grmono/ARDUINO/skarsta/models/hall-encoder/hall-mount.stl

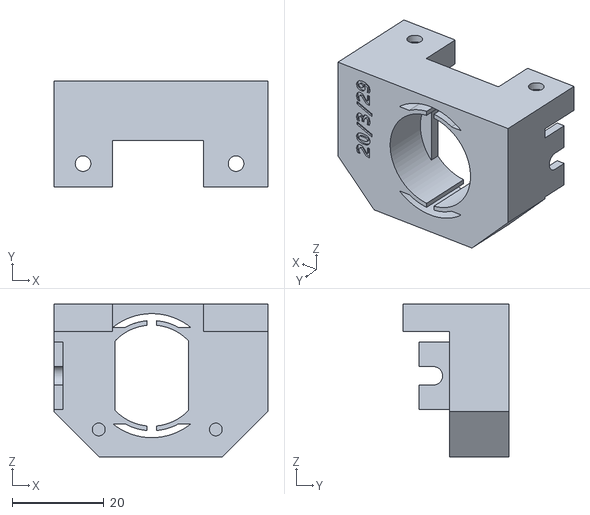
[picture p3: CAD file, 2020-04-01]
skarsta/models/hall-encoder/hall-mount.stl
46.6 x 23.1 x 33.3
