grmono/ARDUINO/skarsta/models/sensor-sonar/sonar-mount.stl

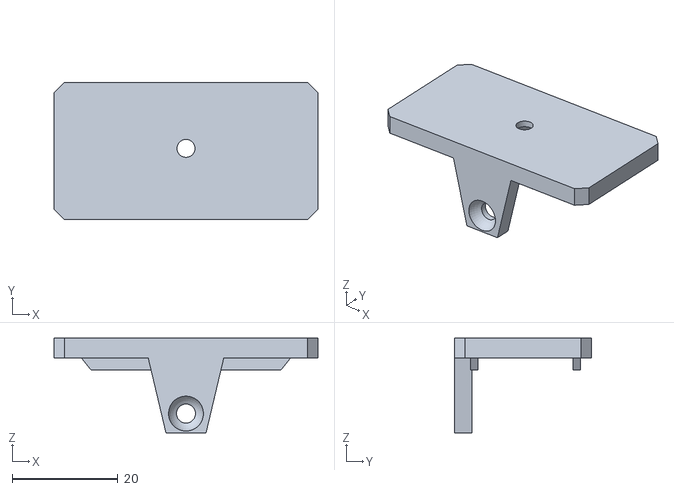
[picture p4: CAD file, 2020-05-26]
skarsta/models/sensor-sonar/sonar-mount.stl
50.0 x 26.0 x 17.9
