grmono/ARDUINO/skarsta/models/hall-encoder/hall-adapter.stl

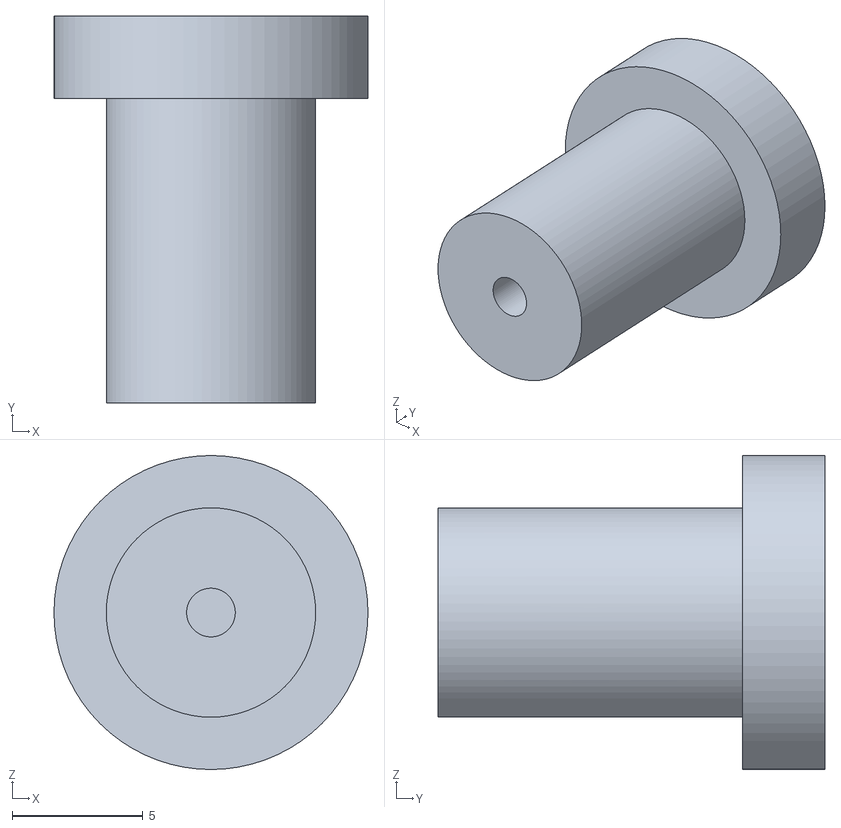
[picture p5: CAD file, 2020-04-01]
skarsta/models/hall-encoder/hall-adapter.stl
12.0 x 14.8 x 12.0
