grmono/ARDUINO/skarsta/models/sensor-sonar/sonar-cap.stl

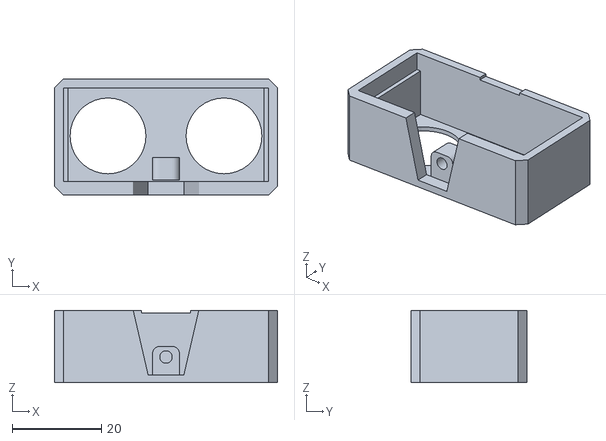
[picture p6: CAD file, 2020-05-26]
skarsta/models/sensor-sonar/sonar-cap.stl
50.0 x 26.0 x 16.2
