grmono/ARDUINO/skarsta/models/hall-encoder/hall-cover.stl

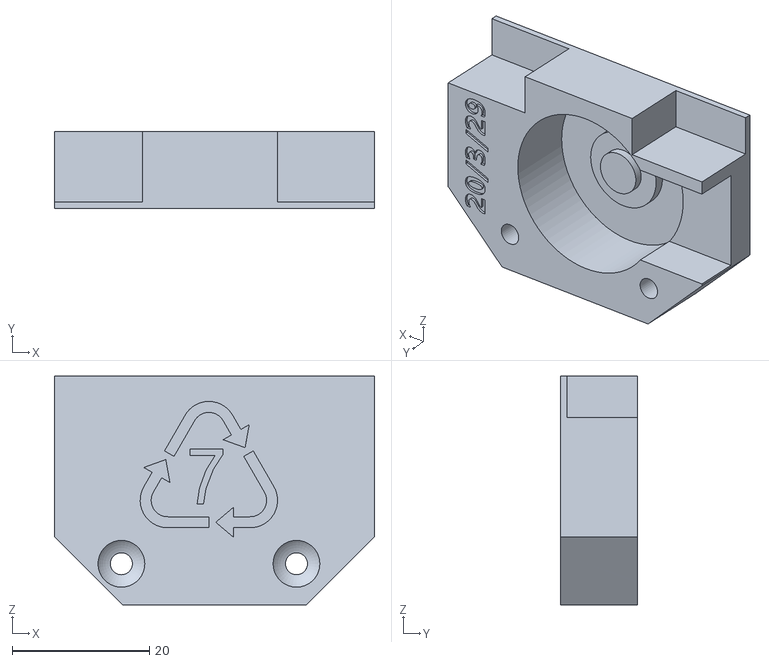
[picture p7: CAD file, 2020-04-01]
skarsta/models/hall-encoder/hall-cover.stl
46.6 x 11.3 x 33.3
