grmono/ARDUINO/(list of files, drawings)

Other design files:
skarsta/docs/wiring-bridge.fzz
skarsta/docs/wiring-ubridge.fzz
skarsta/docs/wiring-urelay.fzz
