grmono/ARDUINO/(commit log)

2020-04-01 Initial impl of hall-encoder && auto-homing
    [hall-adapter.stl, hall-cover.stl, hall-mount.stl]
2020-05-26 Add HC-SR04 sensor support
    - added begin healtchech && init error type
    - added HC-SR04 support && build targets
    - updated docs with STLs and resources regarding HC-SR04
    [configuration.h, sonar-cap.stl, sonar-mount.stl, wiring-bridge.fzz, wiring-ubridge.fzz, wiring-urelay.fzz]
